djiboshin/RLab/electronics/IR2USB/pic5.JPG

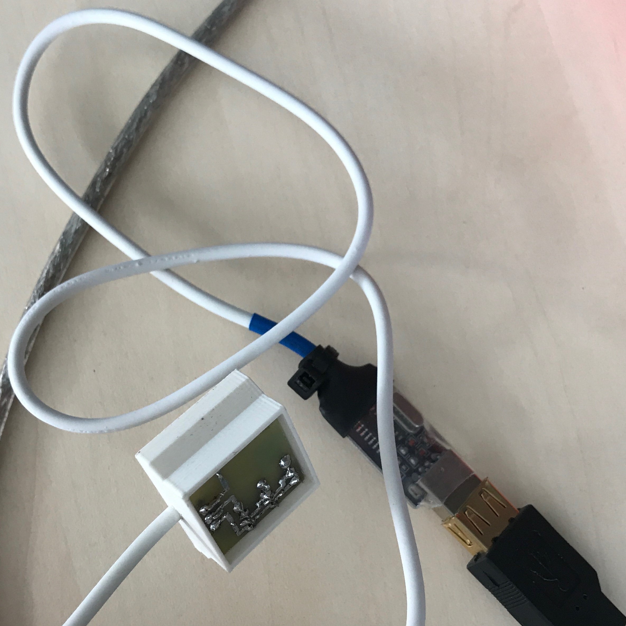
electronics/IR2USB/pic5.JPG
