djiboshin/RLab/electronics/IR2USB/pic3.jpg

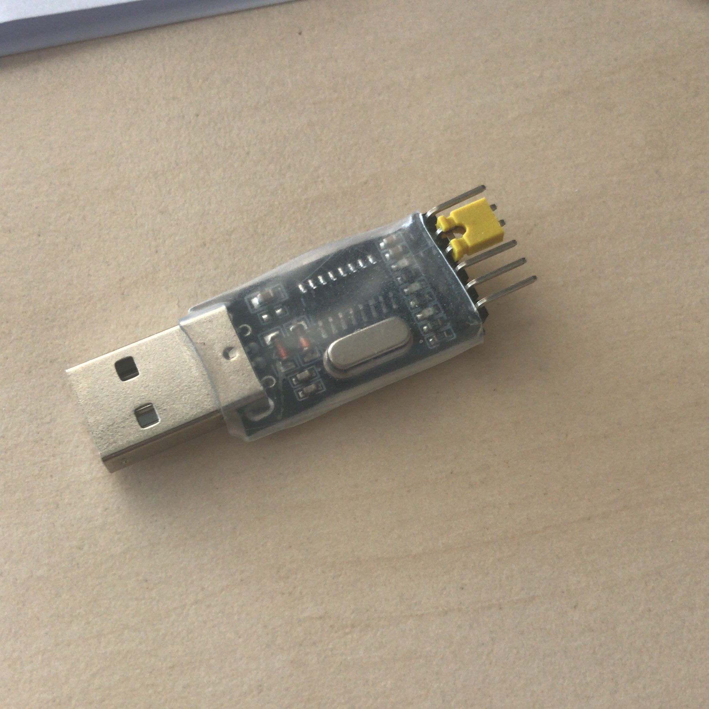
electronics/IR2USB/pic3.jpg
