djiboshin/RLab/API.docx

1. Генератор
  1.1. Команды
    1.1.1. output

Включает/выключает выход генератора:

/generator?C<1|2>_output=<ON|OFF>

Ответ: код ошибки

    1.1.2. vpp

Изменяет напряжение канала:

/generator? C<1|2>_vpp=<X>

Ответ: код ошибки

    1.1.3. freq

Управление частотой канала:

/generator? C<1|2>_freq=<X>

Ответ: код ошибки

    1.1.4. status

Возвращает все установленные значения на канале:

/generator? C<1|2>_status

Ответ: код ошибки 500 или массив состояний

  1.2. Примеры запросов
      - В одном запросе могут быть перемешаны несколько команд
      - Для удобства настройки добавлен тестовый генератор /test_generator/, который будет заменен на /generator/
      - 200 – все ок
      - 500 – ошибка с прибором (не подключен/завис)
      - 400 – ошибка – вы
      - 429 – устройство занято
      - Для каждого запрашиваемого параметра свой ответ
      - Запросы выполняются последовательно в соответствии с запросом, из-за чего status в запросе до output/vpp/freq даст не последние данные

Примеры:

https://172.16.27.33:1880/test_generator?C1_output=ON&C2_output=OFF

{

"C1_output":200,

"C2_output":200

}

https://172.16.27.33:1880/test_generator?C1_output=ha&C2_output=OFF

{

"C1_output":400,

"C2_output":200

}

https://172.16.27.33:1880/test_generator?C1_freq=1000&C1_status

{

"C1_freq":200,

"C1_status":

{

"output":"ON",

"vpp":"10",

"freq":"1000"

}

}

https://172.16.27.33:1880/test_generator?C2_status=1000&C1_status

{

"C2_status":

{

"output":"OFF",

"vpp":"9",

"freq":"2000"

},

"C1_status":

{

"output":"ON",

"vpp":"10",

"freq":"1000"

}

}

https://172.16.27.33:1880/test_generator?C2_status

{

"C2_status": 500

}

2. Установка
  2.1. Команды
    2.1.1. setcoord

Выставление координаты <X> (целое число):

/setup?setcoord=<X>

Ответ: код ошибки

    2.1.2. setcapacity

Выставление емкостей конденсаторов

/setup?setcapacity<1|2>=<1|2|3>

Ответ: код ошибки

    2.1.3. status

Возвращает все установленные значения на установке:

/setup?status

Ответ: код ошибки 500 или массив состояний

  2.2. Примеры
      - В одном запросе могут быть перемешаны несколько команд
      - 200 – все ок
      - 500 – ошибка с прибором (не подключен/завис)
      - 400 – ошибка – вы
      - 429 – устройство занято
      - Для каждого запрашиваемого параметра свой ответ
      - Команда setcoord может выполняться до 30 секунд.
      - Запросы выполняются по порядку списка выше, из-за чего status в запросе до setcoord/setcapacity даст последние данные

https://172.16.27.33:1880/setup?setcoord=5

{

"setcoord":"200"

}

https://172.16.27.33:1880/setup?setcoord=250

{

"setcoord":"400"

}

https://172.16.27.33:1880/setup?setcoord=200&setcapacity2=1&setcapacity1=3

{

"setcoord":"200",

"setcapacity2":"200",

"setcapacity1":"200"

}

https://172.16.27.33:1880/setup?status

{

"status":

{

"getcoord":200,

"getcapacity1":3,

"getcapacity2":1

}

}

https://172.16.27.33:1880/setup?status&setcapacity1=2

{

"status":

{

"getcoord":200,

"getcapacity1":2,

"getcapacity2":1

},

"setcapacity1":"200"

}

3. Осциллограф
  3.1. Команды
    3.1.1. Input

Включает/выключает вход осциллографа:

/oscilloscope?C<1|2>_input=<ON|OFF>

Ответ: код ошибки

    3.1.2. status

Возвращает все параметры канала:

/oscilloscope? C<1|2>_status

Ответ: код ошибки 500 или массив состояний

    3.1.3. autoset

Автоподстройка осциллографа:

/oscilloscope?autoset

Ответ: код ошибки

    3.1.4. screenshot

Снимок экрана и последующее его залитие на /ui/screenshot.png:

/oscilloscope?screenshot

Ответ: код ошибки

  3.2. Примеры
      - В одном запросе могут быть перемешаны несколько команд
      - 200 – все ок
      - 500 – ошибка с прибором (не подключен/завис)
      - 400 – ошибка – вы
      - 429 – устройство занято
      - Запросы выполняются последовательно в соответствии с запросом
      - В тестовом варианте /test_oscilloscope?screenshot скриншот просто переворачивается

https://172.16.27.33:1880/test_oscilloscope?C1_input=ON

{

"C1_input":200

}

https://172.16.27.33:1880/test_oscilloscope?C2_input=OFF&C2_lol=1

{

"C2_input":200,

"C2_lol":400

}

https://172.16.27.33:1880/test_oscilloscope?autoset&screenshot

{

"autoset":200,

"screenshot":200

}

https://172.16.27.33:1880/test_oscilloscope?C1_input=ON&C1_status&C2_status

{

"C1_input":200,

"C1_status":

{

"output":"ON",

"vpp":856.3,

"vamp":428.15,

"freq":467.4

},

"C2_status":

{

"input":"OFF",

"vpp":"0",

"vamp":"0",

"freq":"0"

}

}
