djiboshin/RLab/Artboard 1.png

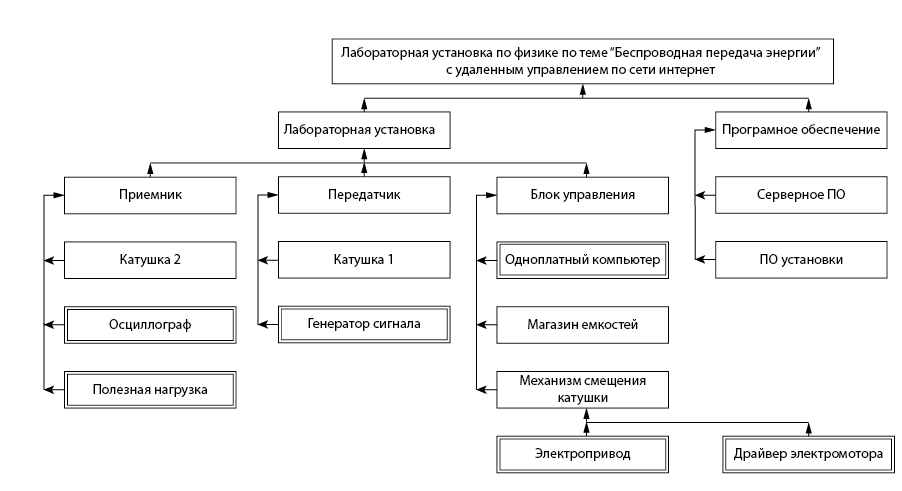
Artboard 1.png
