djiboshin/RLab/electronics/board/board.png

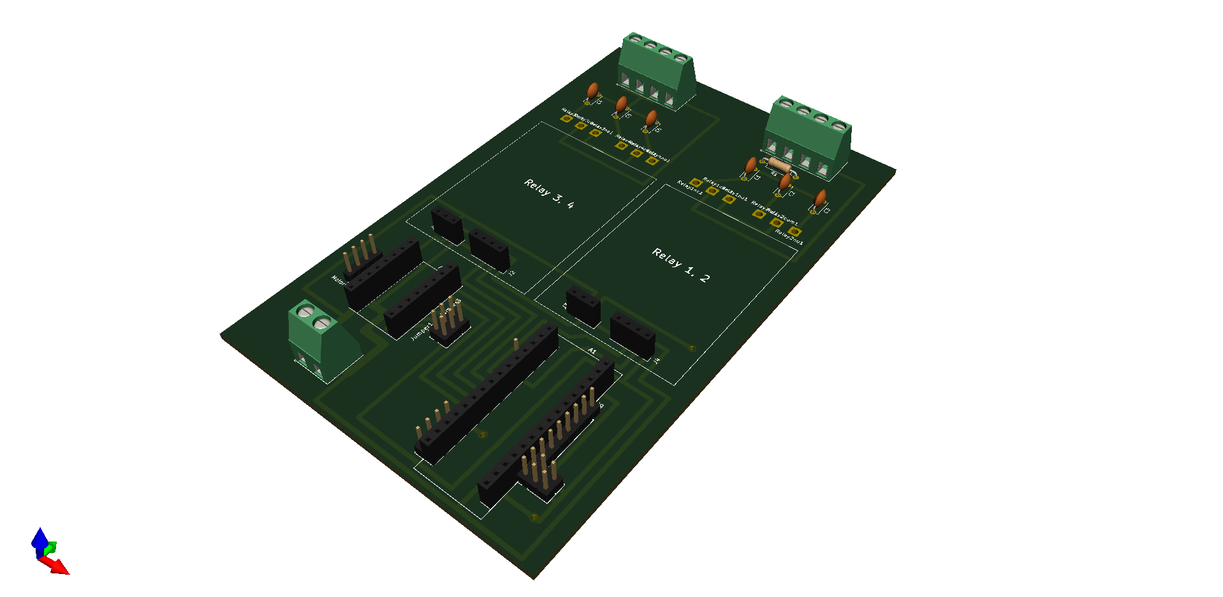
electronics/board/board.png
