djiboshin/RLab/electronics/IR2USB/pic4.JPG

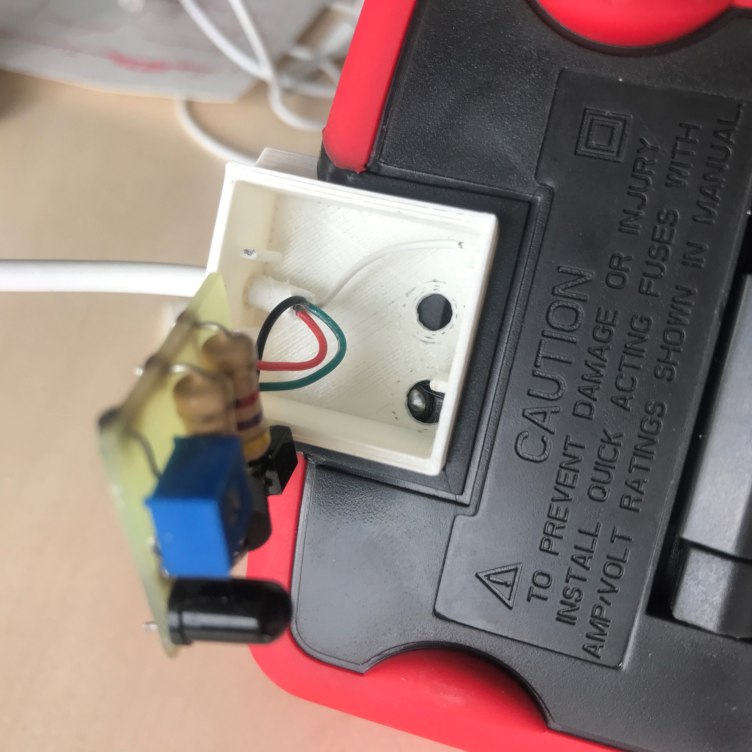
electronics/IR2USB/pic4.JPG
