djiboshin/RLab/front-end-save/images/oscilloscope-screenshot.png

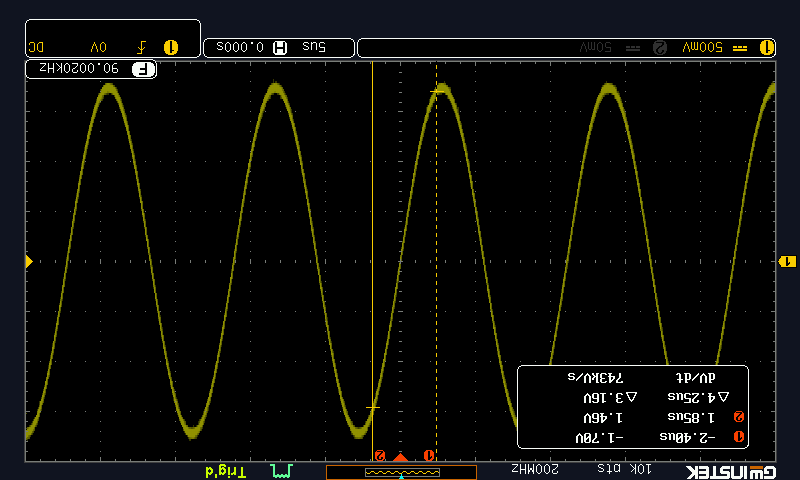
front-end-save/images/oscilloscope-screenshot.png
