djiboshin/RLab/front-end-save/images/oscilloscope-welcome-screenshot.png

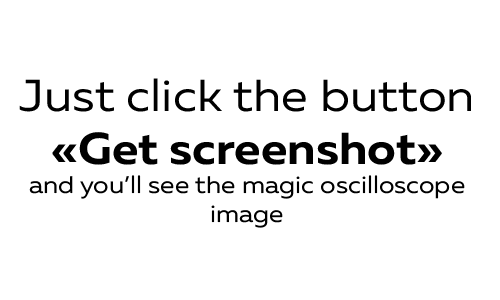
front-end-save/images/oscilloscope-welcome-screenshot.png
