djiboshin/RLab/software/scripts/gdstools-master/screenshot.png

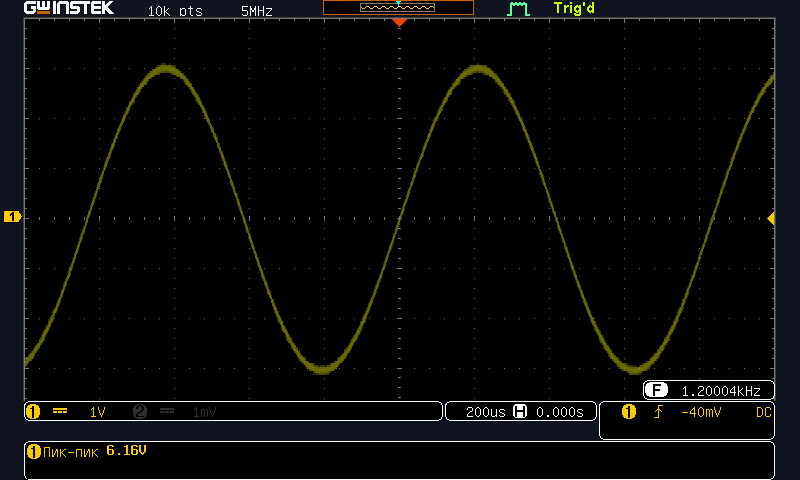
software/scripts/gdstools-master/screenshot.png
