djiboshin/RLab/стол/v3/Сборка1.png

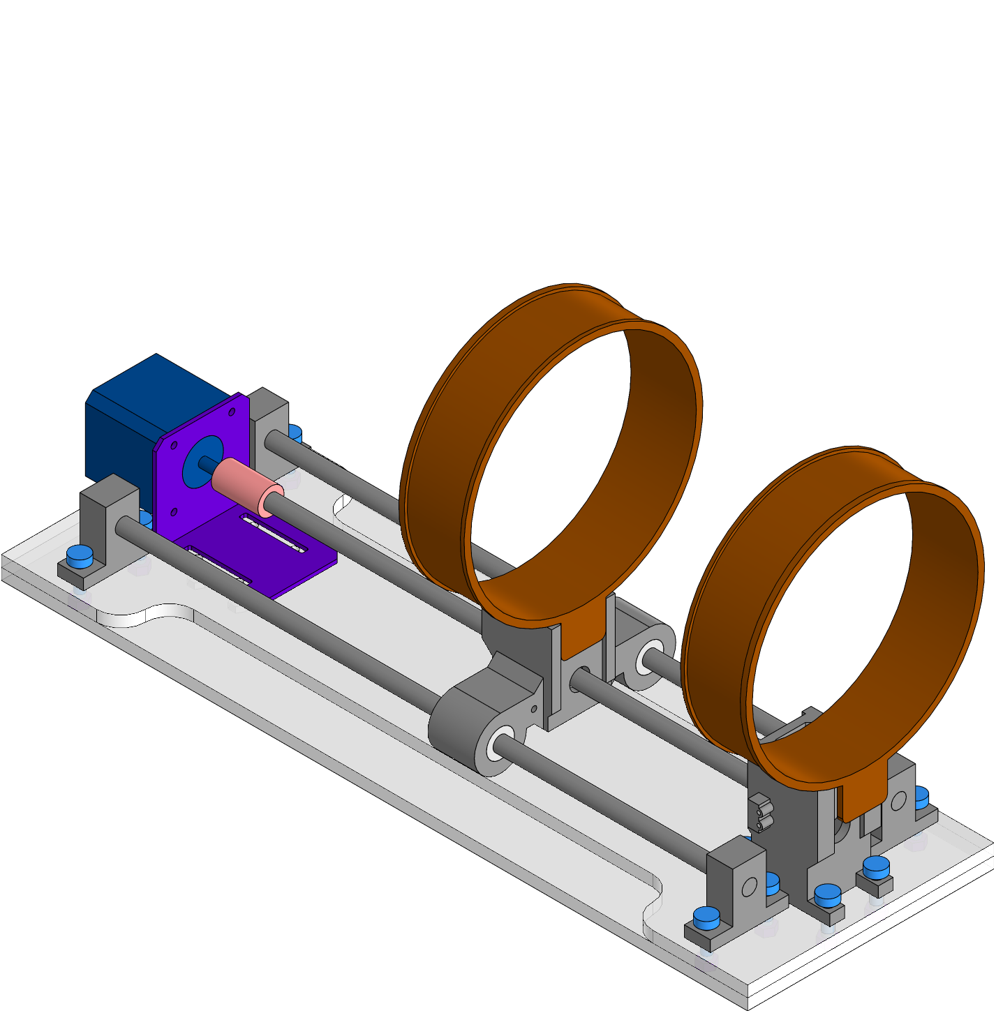
стол/v3/Сборка1.png
