djiboshin/RLab/стол/v3/Сборка2.png

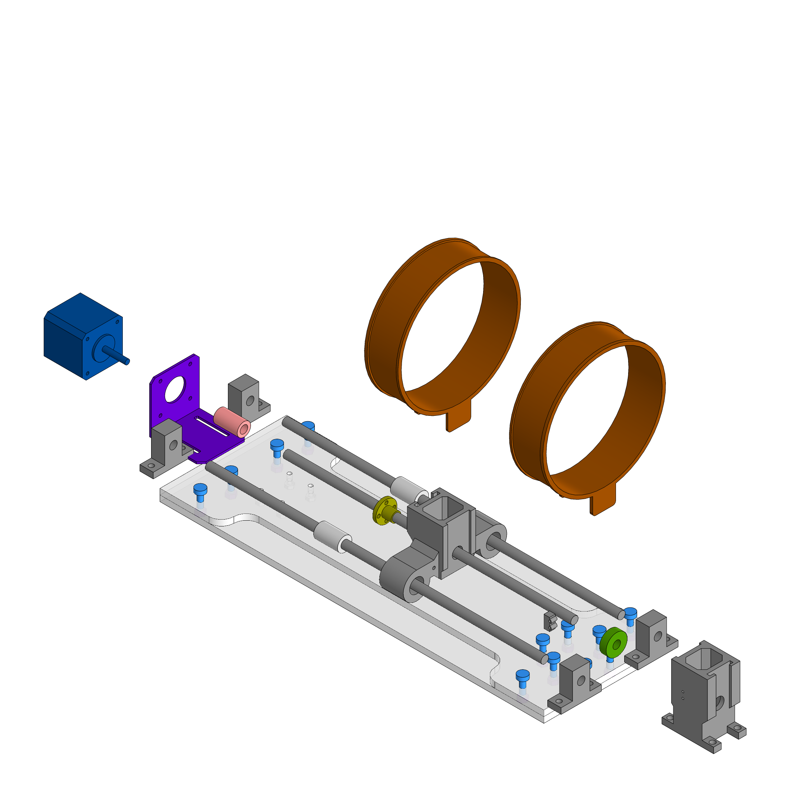
стол/v3/Сборка2.png
