djiboshin/RLab/electronics/IR2USB/крышка.stl

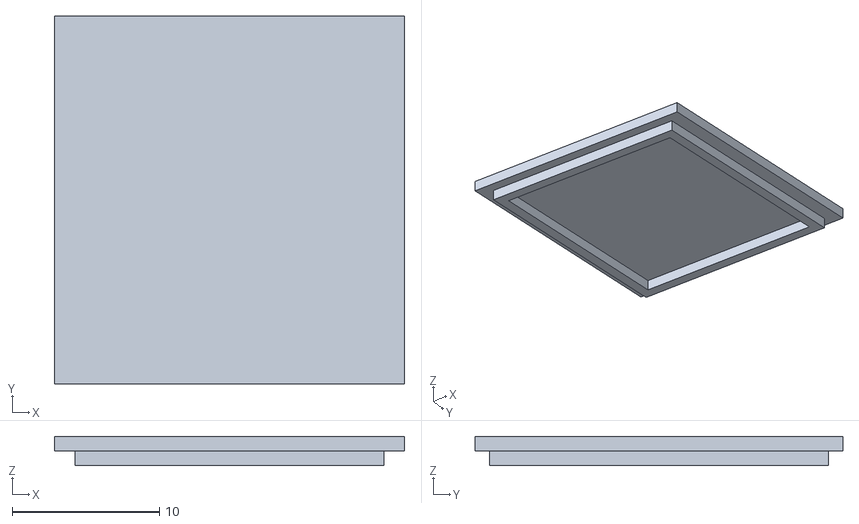
[picture p14: CAD file, 2022-03-15]
electronics/IR2USB/крышка.stl
23.8 x 25.0 x 2.00
