djiboshin/RLab/стол/v3/подшипник.stp

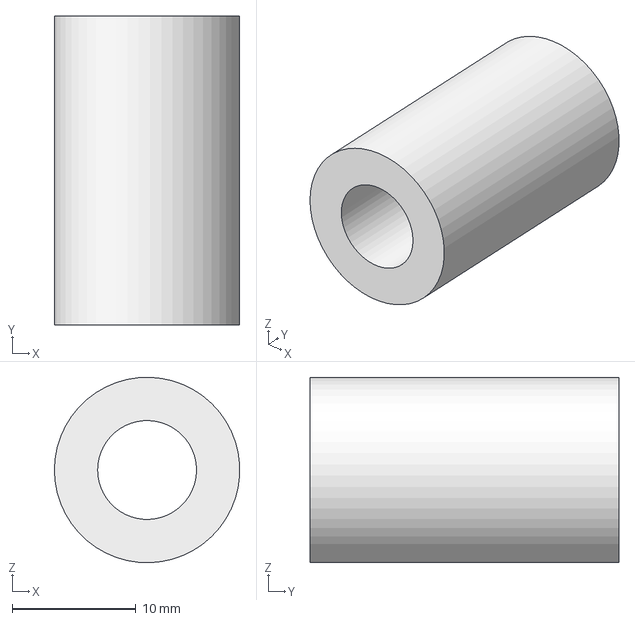
[picture p15: CAD file, 2022-03-15]
стол/v3/подшипник.stp
15.0 x 25.0 x 15.0 mm
