djiboshin/RLab/electronics/IR2USB/корпус.stl

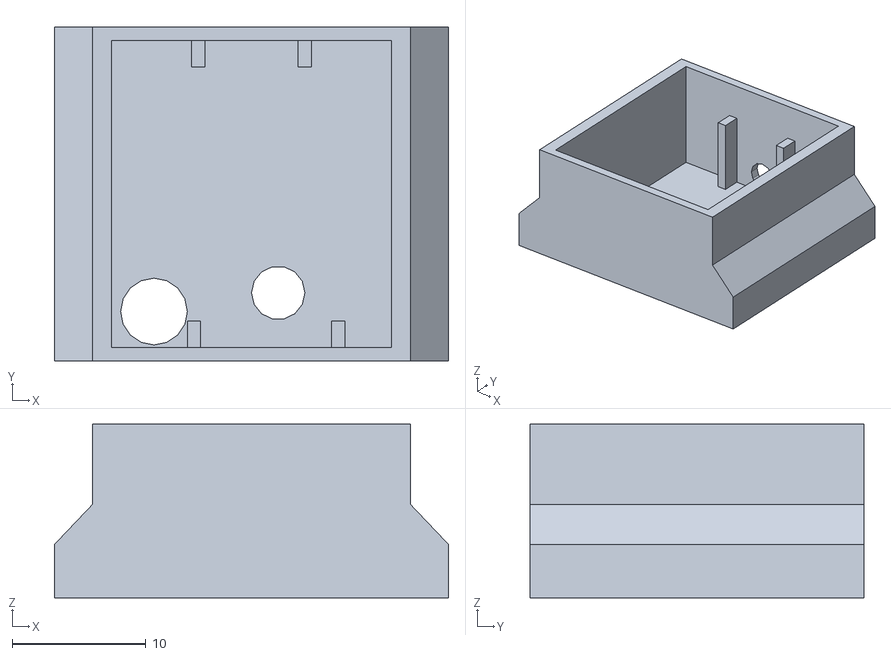
[picture p16: CAD file, 2022-03-15]
electronics/IR2USB/корпус.stl
29.5 x 25.0 x 13.0
