djiboshin/RLab/electronics/board/board.pdf

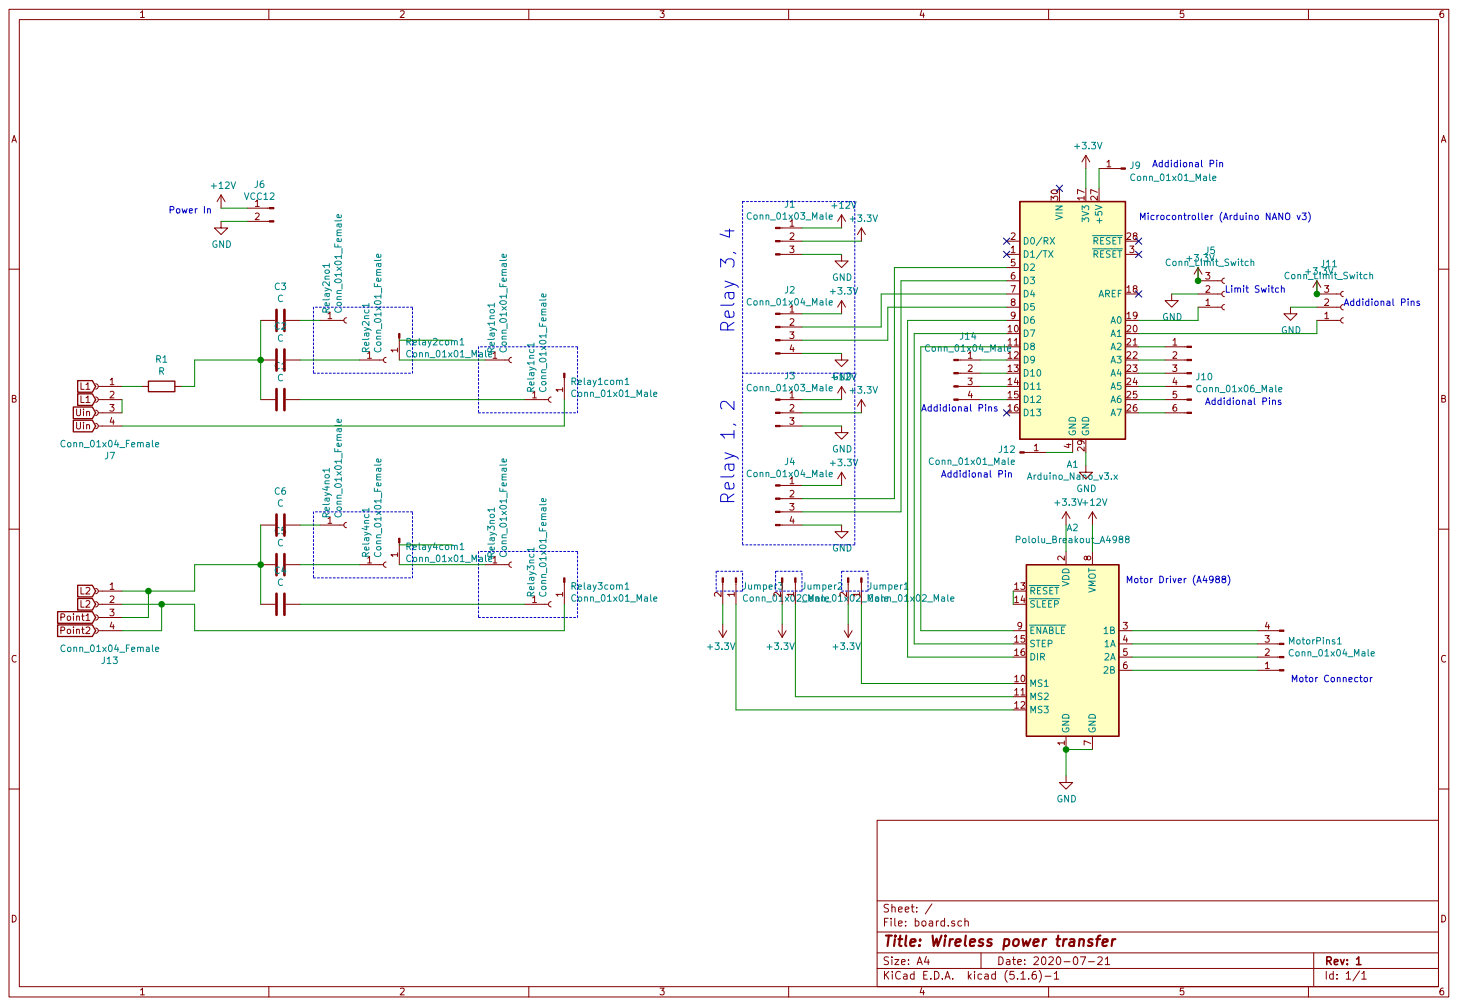
[picture p17: page 1]

1 MS1 10 MS2 11 MS3 12 RESET 13 SLEEP 14 STEP 15 DIR 16 VDD

Id: 1/1 Title: Wireless power transfer File: board.sch Sheet: / +3.3V
