djiboshin/RLab/electronics/board/board2.pdf

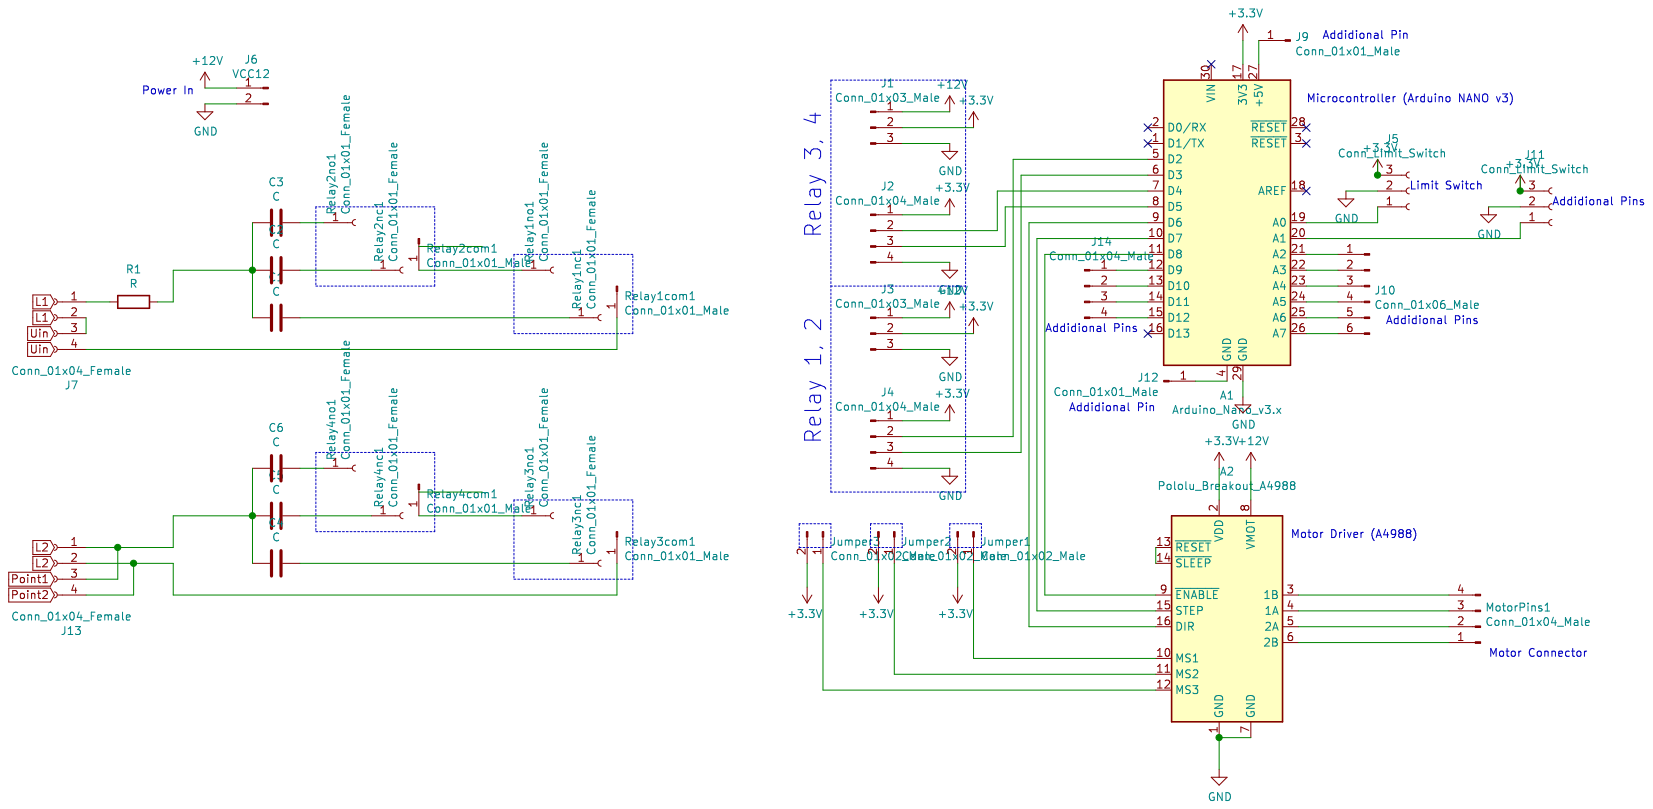
[picture p18: page 1]
