djiboshin/RLab/electronics/IR2USB/board/lol.kicad_pcb

## KiCad design electronics/IR2USB/board/lol.kicad_pcb (2022-03-15)

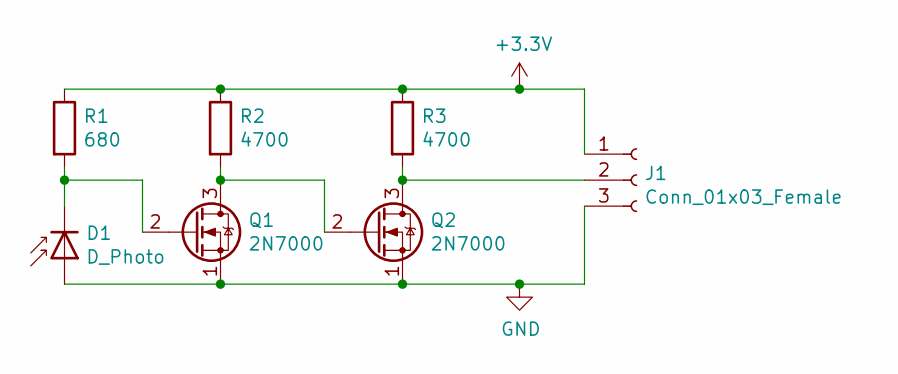
[picture p19: schematic lol.sch]

Parts:
D1: D_Photo; R_LDR_4.9x4.2mm_P2.54mm_Vertical
J1: Conn_01x03_Female; PinHeader_1x03_P2.54mm_Vertical
Q1, Q2: 2N7000; TO-92_Inline
R1: 680; R_Axial_DIN0411_L9.9mm_D3.6mm_P12.70mm_Horizontal
R2, R3: 4700; R_Axial_DIN0411_L9.9mm_D3.6mm_P12.70mm_Horizontal

Connections:
+3V3: J1.1, R1.1, R2.1, R3.1
GND: D1.2 (A), J1.3, Q1.1 (S), Q2.1 (S)
unnamed: D1.1 (K), Q1.2 (G), R1.2
unnamed: J1.2, Q2.3 (D), R3.2
unnamed: Q1.3 (D), Q2.2 (G), R2.2

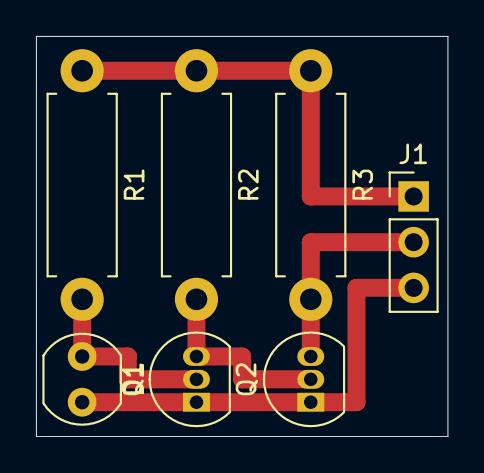
[picture p20: board lol.kicad_pcb from above]

Board: 2 copper layers, 22.9 x 22.2 mm, 7 parts (0 on the bottom side), 5 nets.
