djiboshin/RLab/electronics/board/board.kicad_pcb

## KiCad design electronics/board/board.kicad_pcb (2022-03-15)

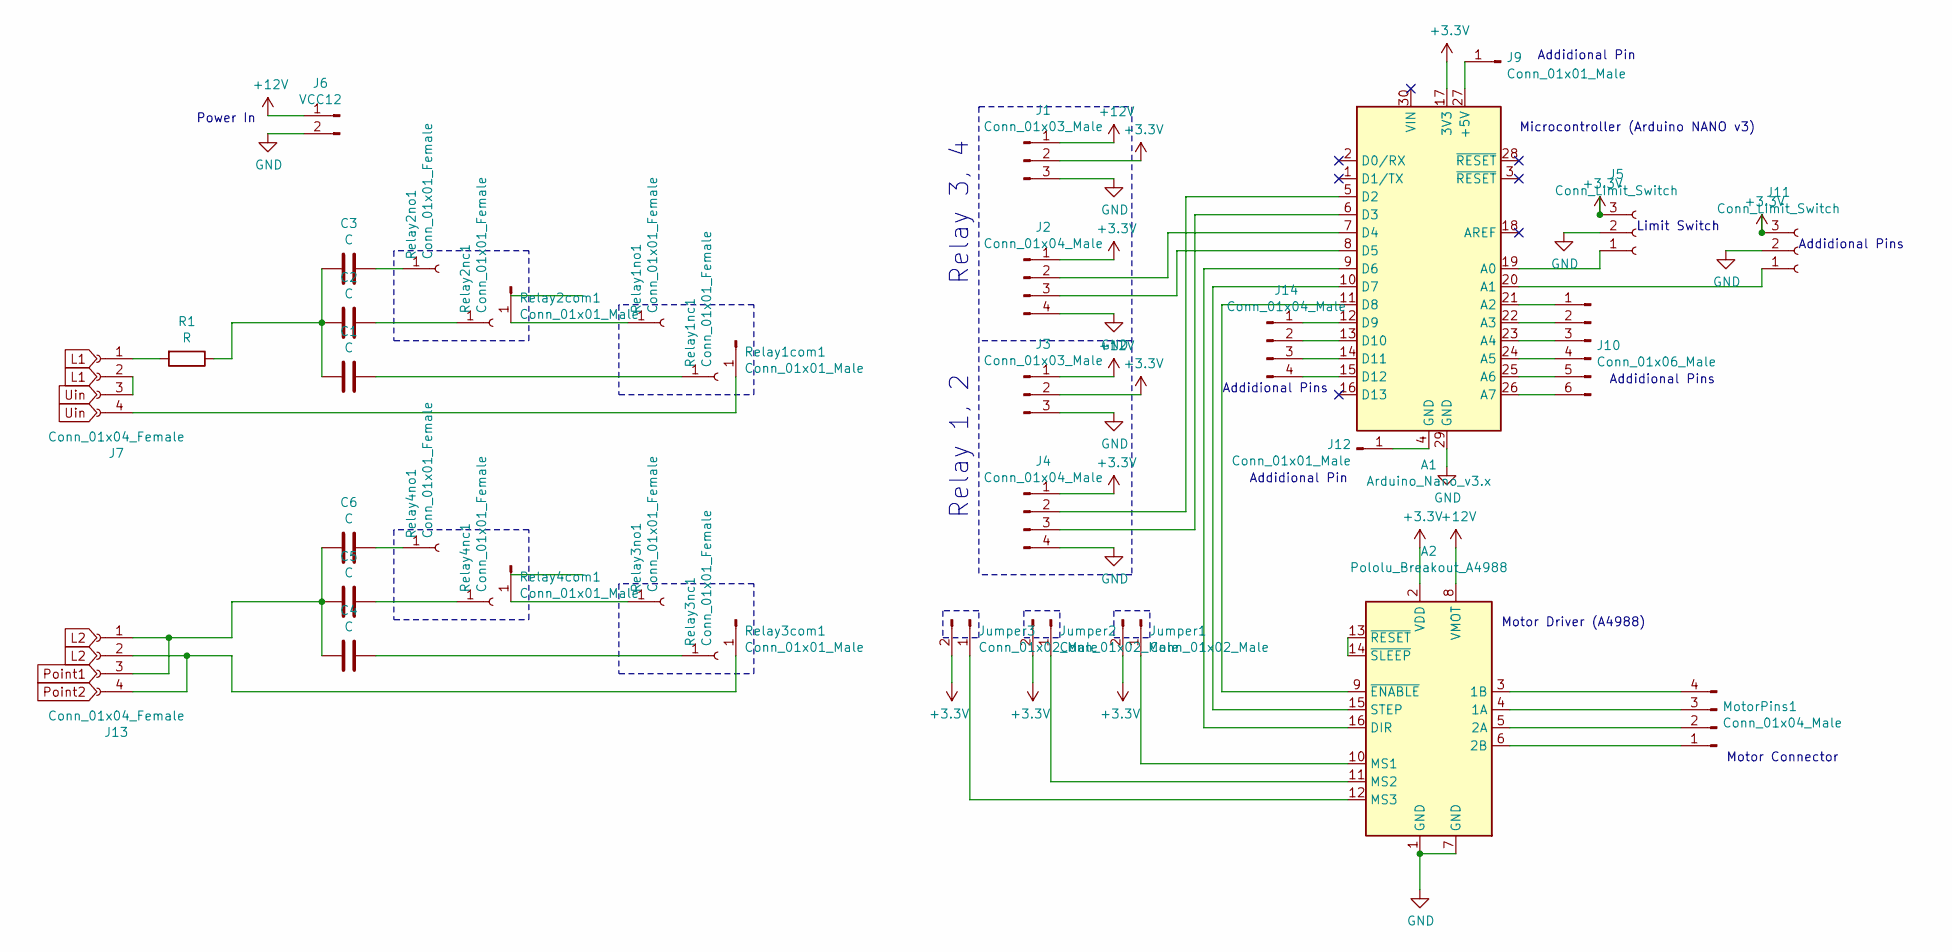
[picture p21: schematic board.sch, Wireless power transfer]

Parts:
A1: Arduino_Nano_v3.x; Arduino_Nano
A2: Pololu_Breakout_A4988; Pololu_Breakout-16_15.2x20.3mm
C1, C2, C3, C4, C5, C6: C; C_Disc_D5.0mm_W2.5mm_P5.00mm
J1, J3: Conn_01x03_Male; PinSocket_1x03_P2.54mm_Vertical
J2, J4: Conn_01x04_Male; PinSocket_1x04_P2.54mm_Vertical
J5, J11: Conn_Limit_Switch; PinHeader_1x03_P2.54mm_Vertical
J6: VCC12; TerminalBlock_Phoenix_MKDS-1,5-2-5.08_1x02_P5.08mm_Horizont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
J7, J13: Conn_01x04_Female; TerminalBlock_Phoenix_MKDS-1,5-4-5.08_1x04_P5.08mm_Horizont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
J9, J12: Conn_01x01_Male; PinHeader_1x01_P2.54mm_Vertical
J10: Conn_01x06_Male; PinHeader_1x06_P2.54mm_Vertical
J14: Conn_01x04_Male; PinHeader_1x04_P2.54mm_Vertical
Jumper1, Jumper2, Jumper3: Conn_01x02_Male; PinHeader_1x02_P2.54mm_Vertical
MotorPins1: Conn_01x04_Male; PinHeader_1x04_P2.54mm_Vertical
R1: R; R_Axial_DIN0207_L6.3mm_D2.5mm_P10.16mm_Horizontal
Relay1com1, Relay2com1, Relay3com1, Relay4com1: Conn_01x01_Male; SolderWire-1sqmm_1x01_D1.4mm_OD2.7mm
Relay1nc1, Relay1no1, Relay2nc1, Relay2no1, Relay3nc1, Relay3no1, Relay4nc1, Relay4no1: Conn_01x01_Female; SolderWire-1sqmm_1x01_D1.4mm_OD2.7mm

Connections:
+3V3: A1.17 (3V3), A2.2 (VDD), J1.2, J2.1, J3.2, J4.1, J5.3, J11.3, Jumper1.2, Jumper2.2, Jumper3.2
+12V: A2.8 (VMOT), J1.1, J3.1, J6.1
GND: A1.29 (GND), A2.1 (GND), A2.7 (GND), J1.3, J2.4, J3.3, J4.4, J5.2, J6.2, J11.2
unnamed: A1.4 (GND), J12.1
unnamed: A1.5 (D2), J4.2
unnamed: A1.6 (D3), J4.3
unnamed: A1.7 (D4), J2.2
unnamed: A1.8 (D5), J2.3
unnamed: A1.9 (D6), A2.16 (DIR)
unnamed: A1.10 (D7), A2.15 (STEP)
unnamed: A1.11 (D8), A2.9 (~ENABLE)
unnamed: A1.12 (D9), J14.1
unnamed: A1.13 (D10), J14.2
unnamed: A1.14 (D11), J14.3
unnamed: A1.15 (D12), J14.4
unnamed: A1.19 (A0), J5.1
unnamed: A1.20 (A1), J11.1
unnamed: A1.21 (A2), J10.1
unnamed: A1.22 (A3), J10.2
unnamed: A1.23 (A4), J10.3
unnamed: A1.24 (A5), J10.4
unnamed: A1.25 (A6), J10.5
unnamed: A1.26 (A7), J10.6
unnamed: A1.27 (+5V), J9.1
unnamed: A2.3 (1B), MotorPins1.4
unnamed: A2.4 (1A), MotorPins1.3
unnamed: A2.5 (2A), MotorPins1.2
unnamed: A2.6 (2B), MotorPins1.1
unnamed: A2.10 (MS1), Jumper1.1
unnamed: A2.11 (MS2), Jumper2.1
unnamed: A2.12 (MS3), Jumper3.1
unnamed: A2.13 (~RESET), A2.14 (~SLEEP)
unnamed: C1.1, C2.1, C3.1, R1.1
unnamed: C1.2, Relay1nc1.1
unnamed: C2.2, Relay2nc1.1
unnamed: C3.2, Relay2no1.1
unnamed: C4.1, C5.1, C6.1, J13.1, J13.3
unnamed: C4.2, Relay3nc1.1
unnamed: C5.2, Relay4nc1.1
unnamed: C6.2, Relay4no1.1
unnamed: J7.1, R1.2
unnamed: J7.2, J7.3
unnamed: J7.4, Relay1com1.1
unnamed: J13.2, J13.4, Relay3com1.1
unnamed: Relay1no1.1, Relay2com1.1
unnamed: Relay3no1.1, Relay4com1.1

Notes on the sheet:
Relay 3, 4
Relay 1, 2
Power In
Limit Switch
Motor Connector
Motor Driver (A4988)
Microcontroller (Arduino NANO v3)
Addidional Pins
Addidional Pin

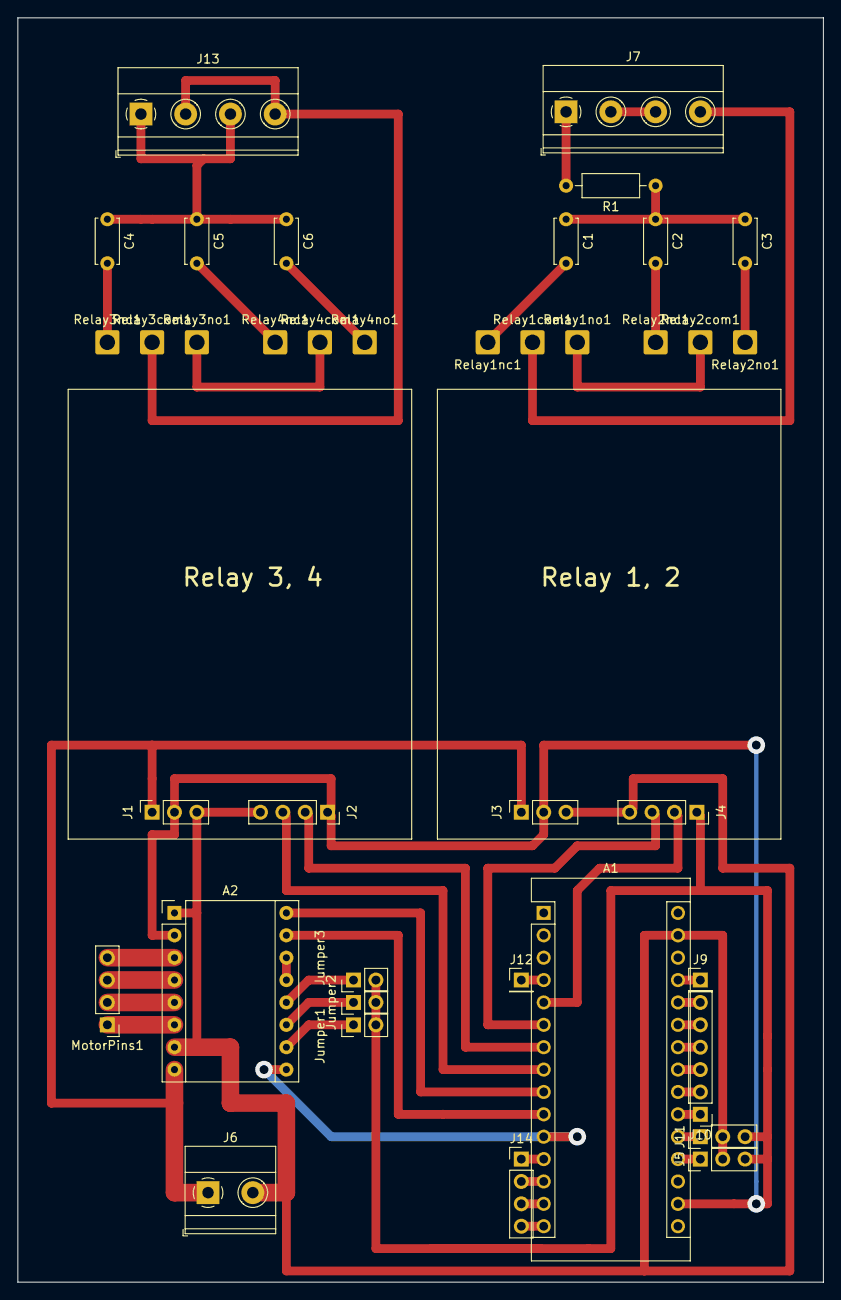
[picture p22: board board.kicad_pcb from above]

Board: 2 copper layers, 91.4 x 143.5 mm, 38 parts (0 on the bottom side), 46 nets.
